kywls405/WineQueen/docs/WineQueen-development-report.pdf

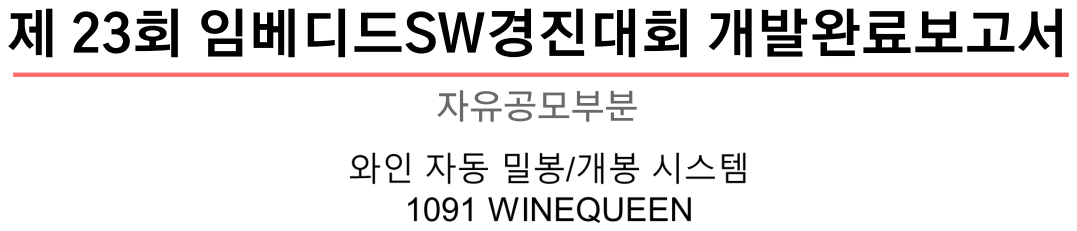
[picture p1: page 1]
제 23회 임베디드SW경진대회 개발완료보고서; 자유공모부분

## PART 1 - 개발개요

# 개발 배경 및 구현 동기

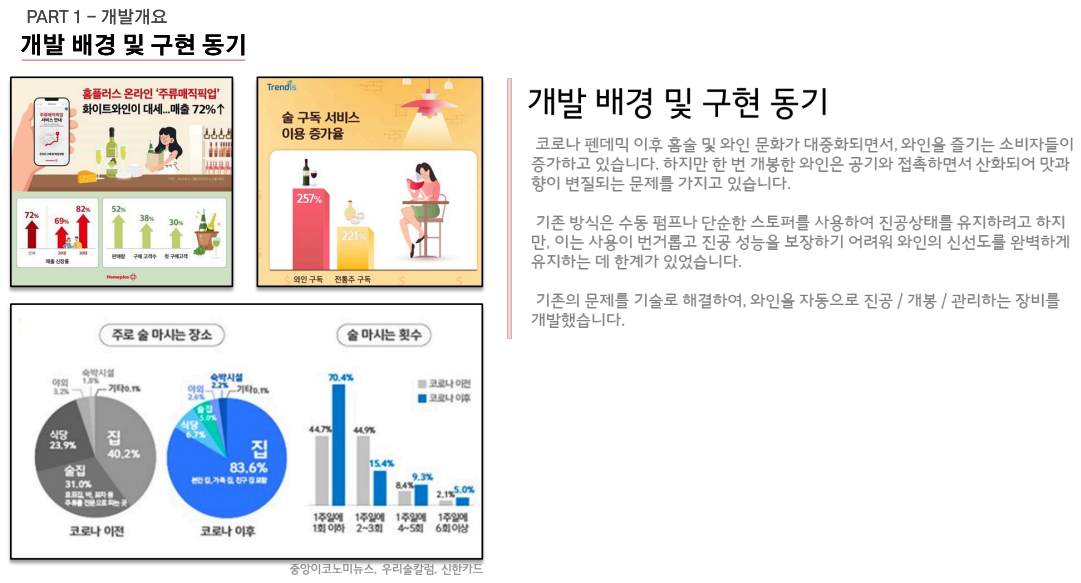
[picture p2: page 2]

## PART 1 - 개발개요

# 필요성 및 목표

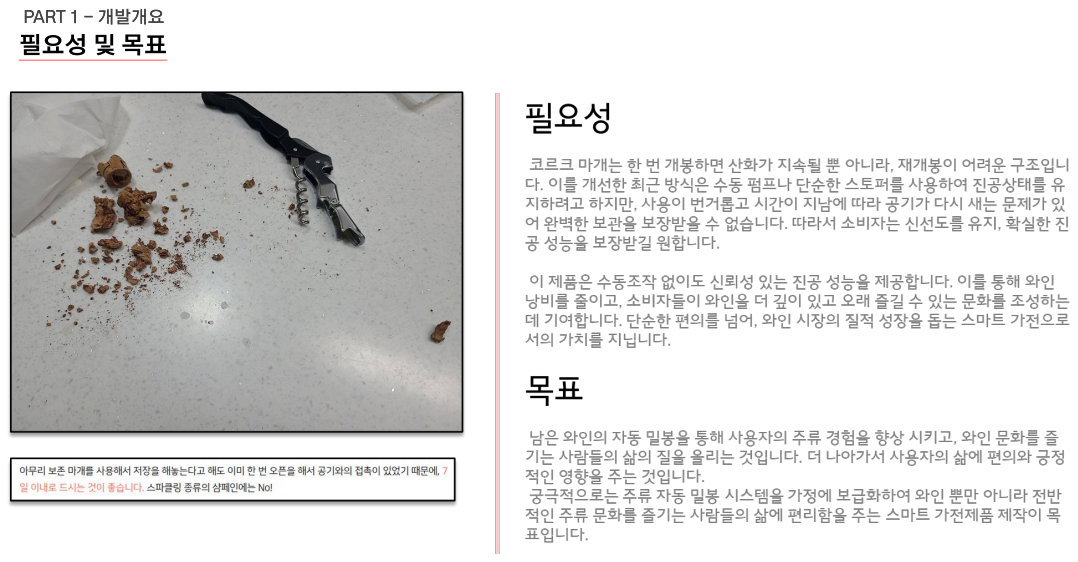
[picture p3: page 3]

## PART 1 - 개발개요

# 소스코드 및 시연동영상

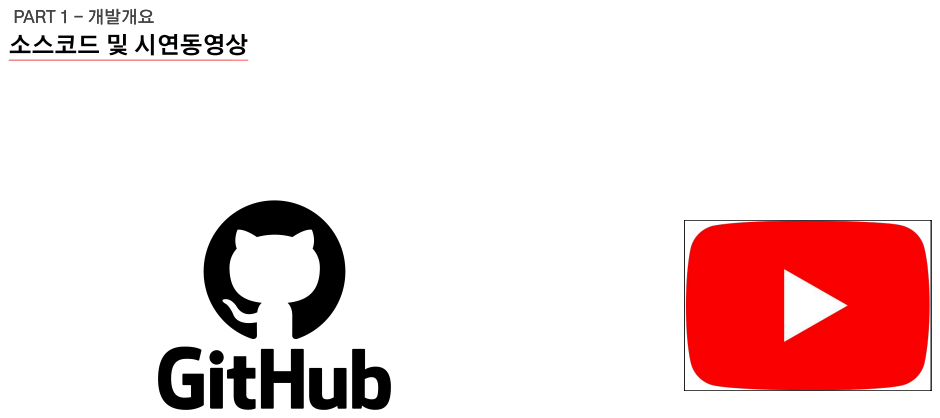
[picture p4: page 4]

## PART 2 - 개발 환경 설명

# HW구성 및 기능

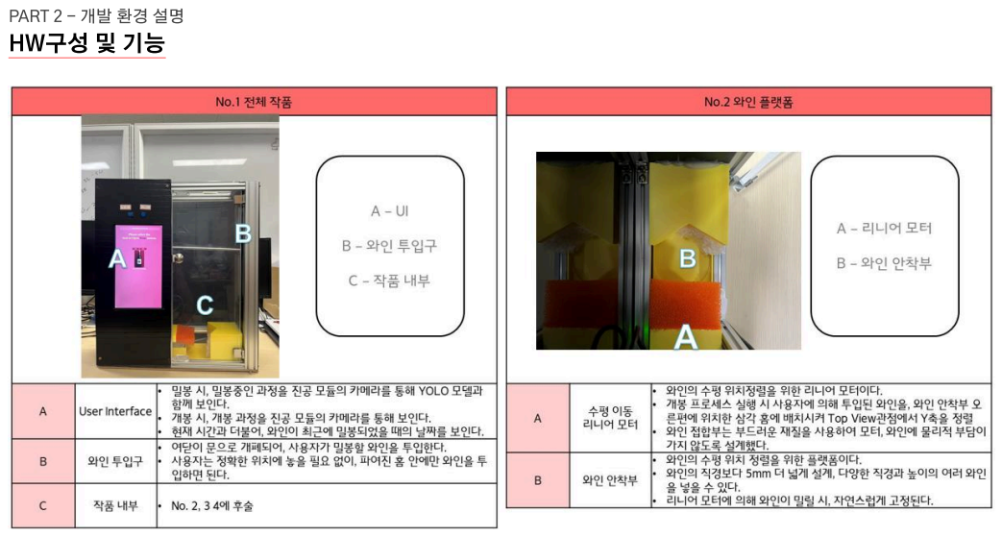
[picture p5: page 5]

## PART 2 - 개발 환경 설명

# HW구성 및 기능

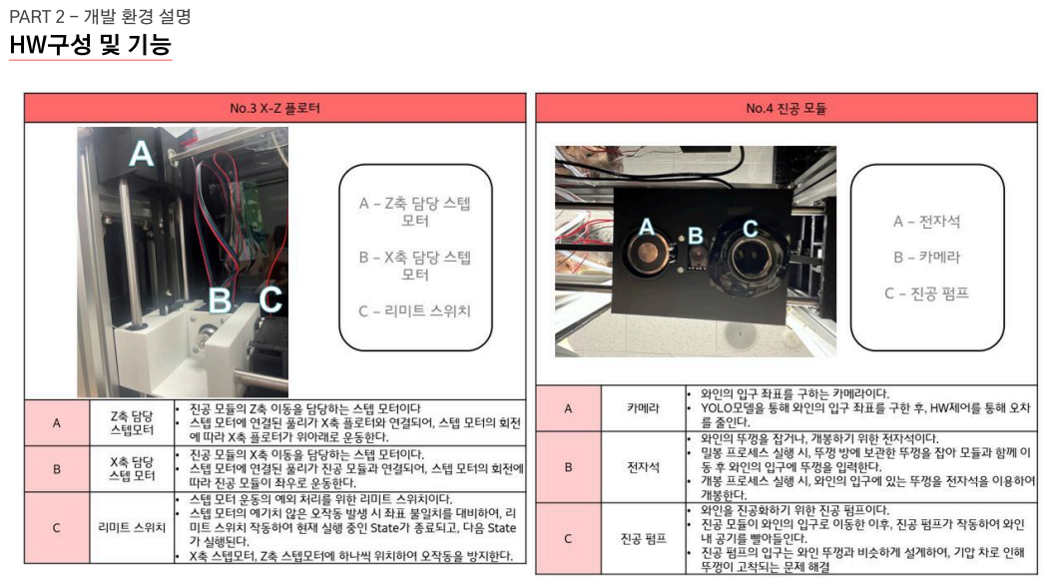
[picture p6: page 6]

### PART 2 - 개발 환경 설명

# 개발 환경 & 파트별 연결

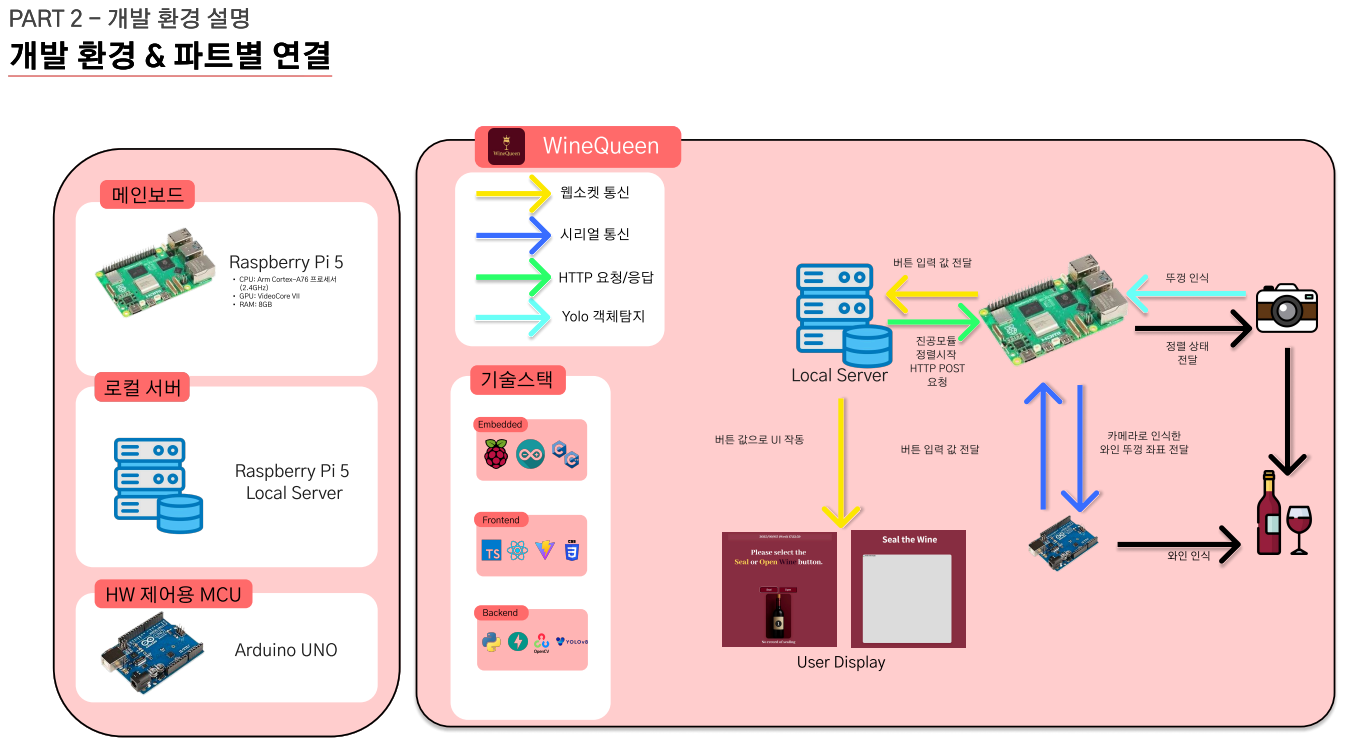
[picture p7: page 7]
Raspberry Pi 5 Local Server; Arduino UNO; 메인보드; 기술스택; Raspberry Pi 5; 기기하드웨어 제어; Local Server; 진공모듈 정렬시작; HTTP POST 요청; WineQueen; 시리얼 통신; 웹소켓 통신; Yolo 객체탐지; User Display; Frontend; Backend; Embedded

PART 2 - 개발 환경 설명
개발 환경 & 파트별 연결

HTTP 요청/응답

CPU: Arm Cortex-A76 프로세서
(2.4GHz)
GPU: VideoCore VII
RAM: 8GB

CPU: BCM2712 쿼드코어 Arm Cortex-A76 프로세서(2.4GHz)

카메라로 인식한

버튼 값으로 UI 작동
웹소켓으로 받은 버튼 값

HW 제어용 MCU

## PART 3 - 개발 프로그램 설명

# SW구성 및 핵심 기능

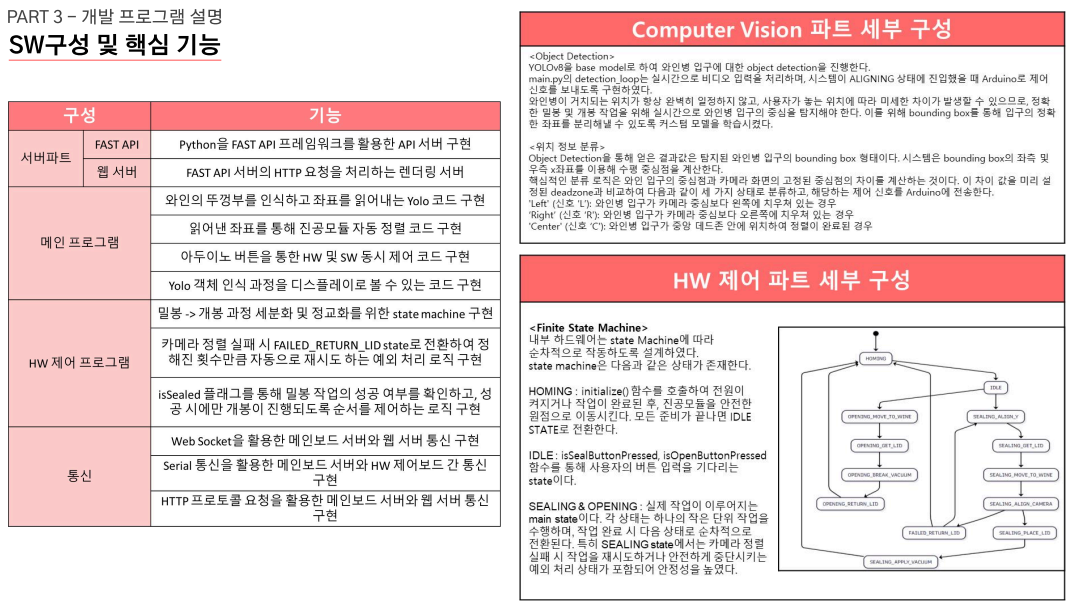
[picture p8: page 8]

## PART 3 - 개발 프로그램 설명

# 함수별 기능 - 1

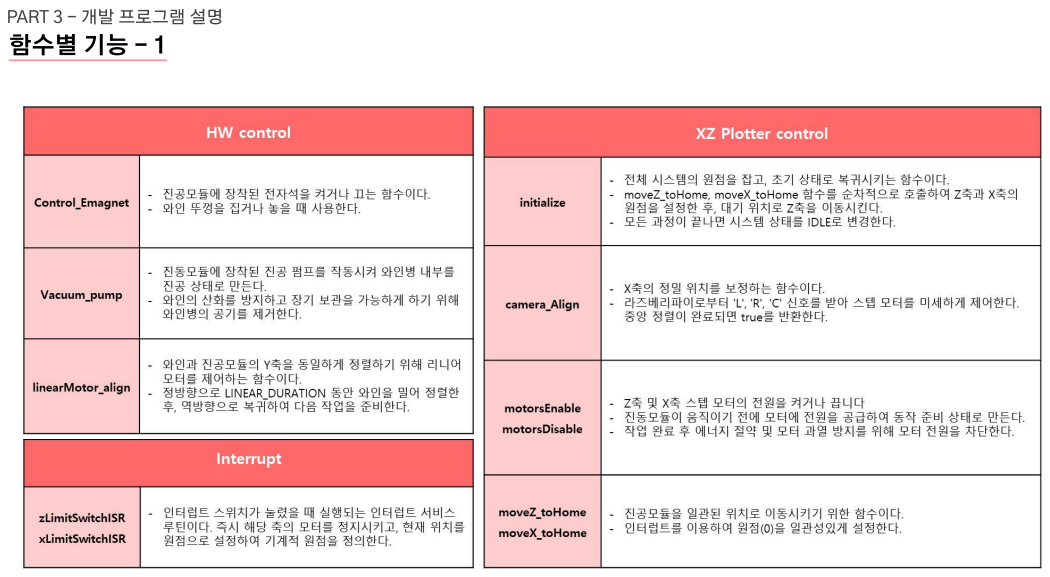
[picture p9: page 9]

## PART 3 - 개발 프로그램 설명

# 함수별 기능 - 2

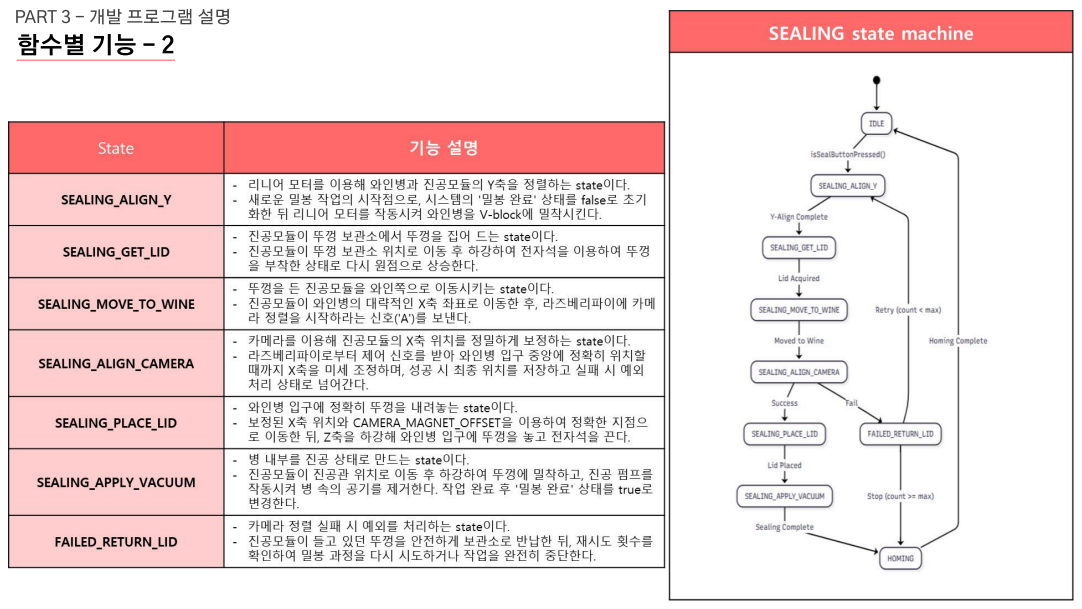
[picture p10: page 10]

## PART 3 - 개발 프로그램 설명

# 함수별 기능 - 3

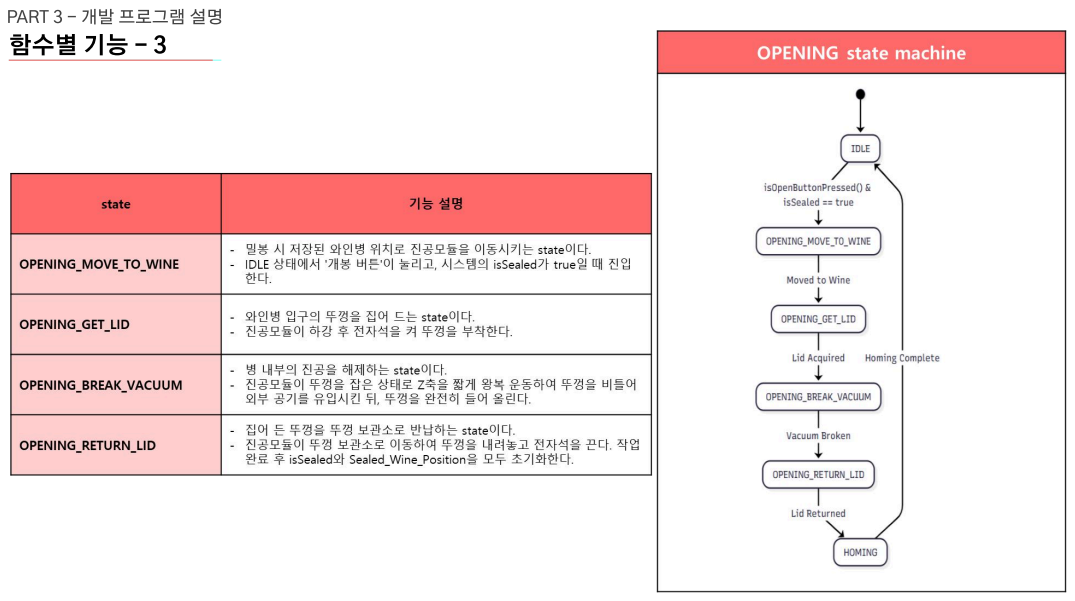
[picture p11: page 11]

## PART 3 - 개발 프로그램 설명

# 파일 구성 및 기술적 차별성

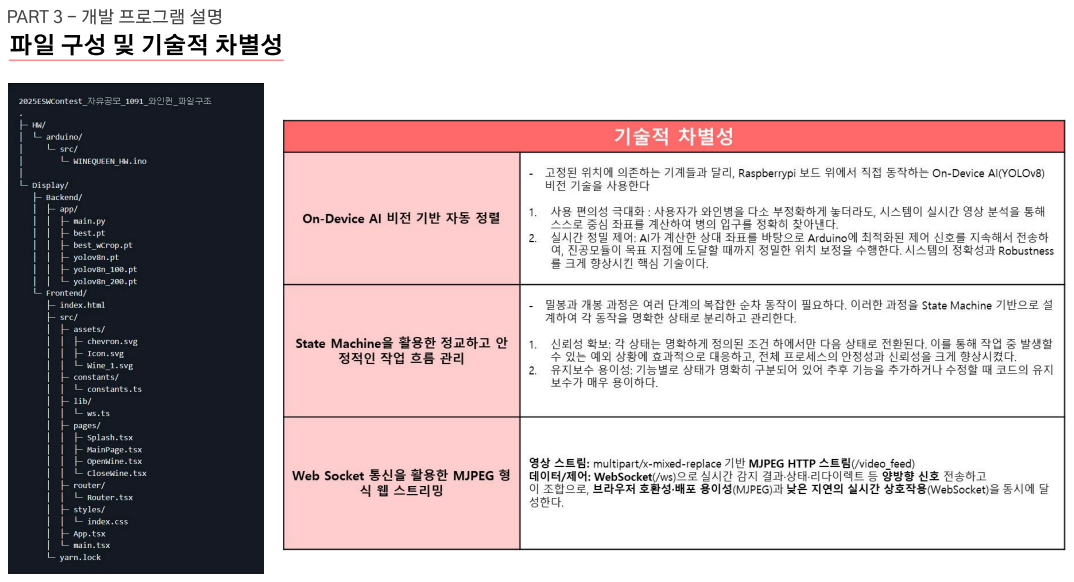
[picture p12: page 12]
파일 구성도 마크다운으로 구성하고 그냥 캡쳐 & 붙여넣 기 하는게 편 함

## PART 4 - 개발 중 발생한 장애요인과 해결방안

# 장애요인 및 해결방안

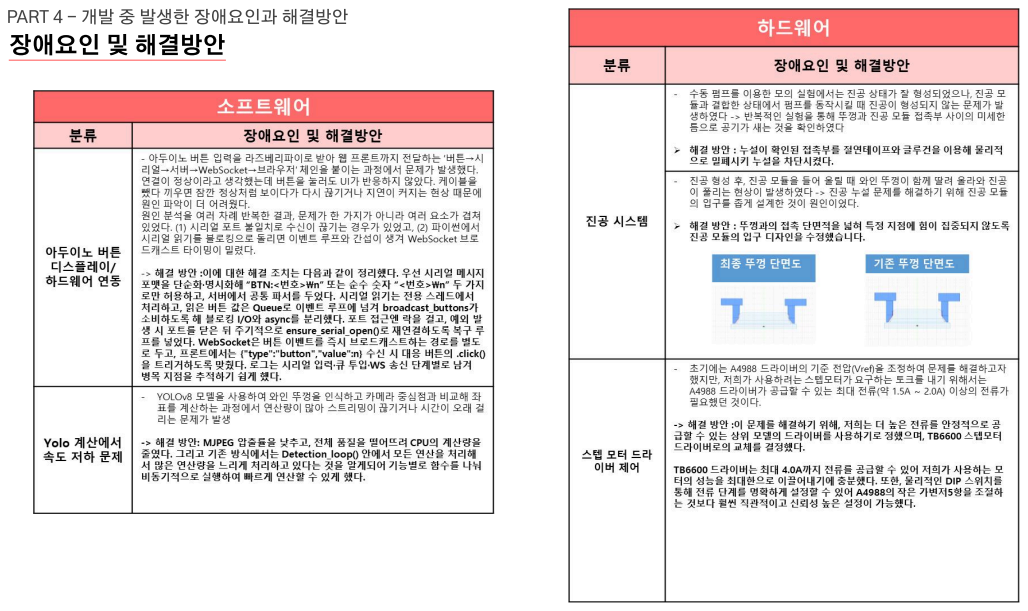
[picture p13: page 13]

## PART 5 - 개발 결과물의 차별성

# 작품의 차별성 및 우수성

기존 와인 스토퍼 | WineQueen

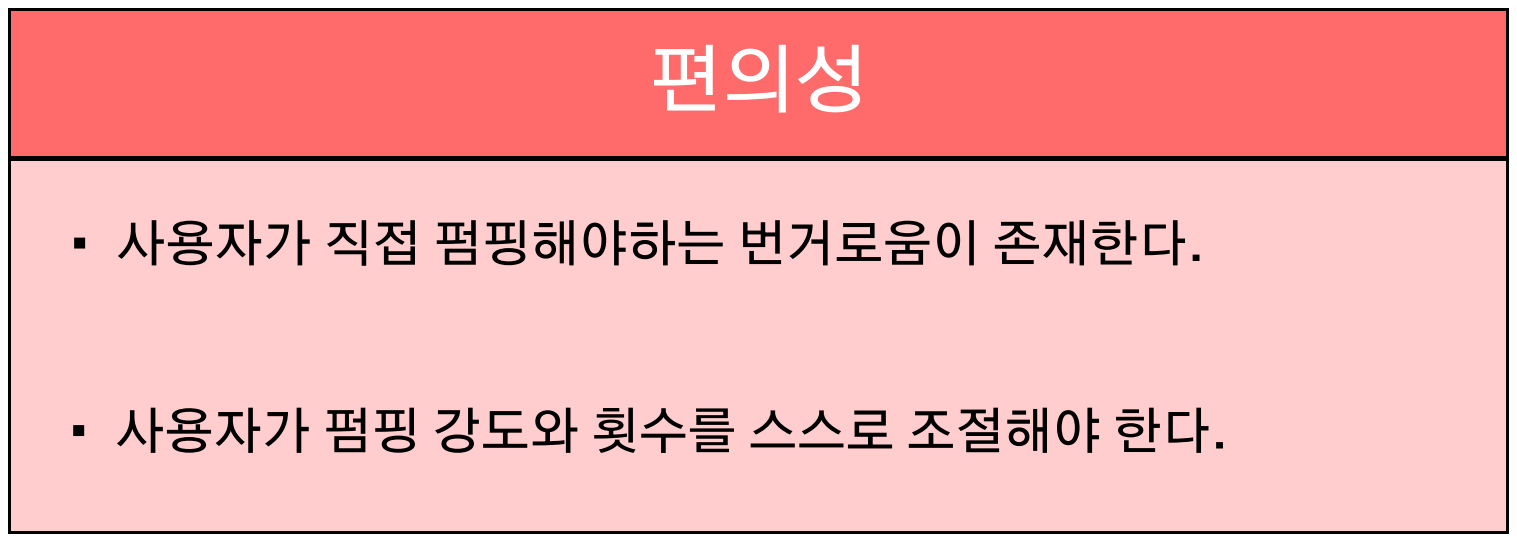
[picture p14: figure]
편의성; 사용자가 직접 펌핑해야하는 번거로움이 존재한다.; 사용자가 펌핑 강도와 횟수를 스스로 조절해야 한다.
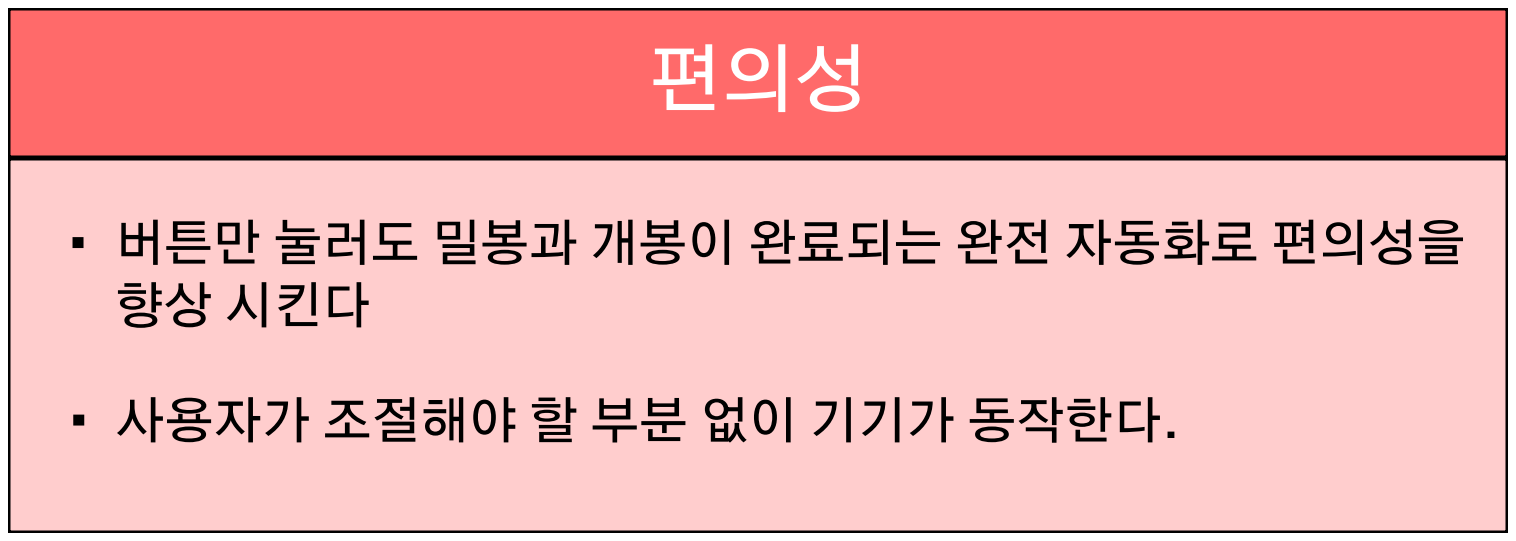
[picture p15: figure]
편의성; 버튼 만 눌러도 밀봉과 개봉이 완료되는 완전 자동화로 편의성을 향상 시킨다; 사용자가 조절해야 할 부분 없이 기기가 동작한다.
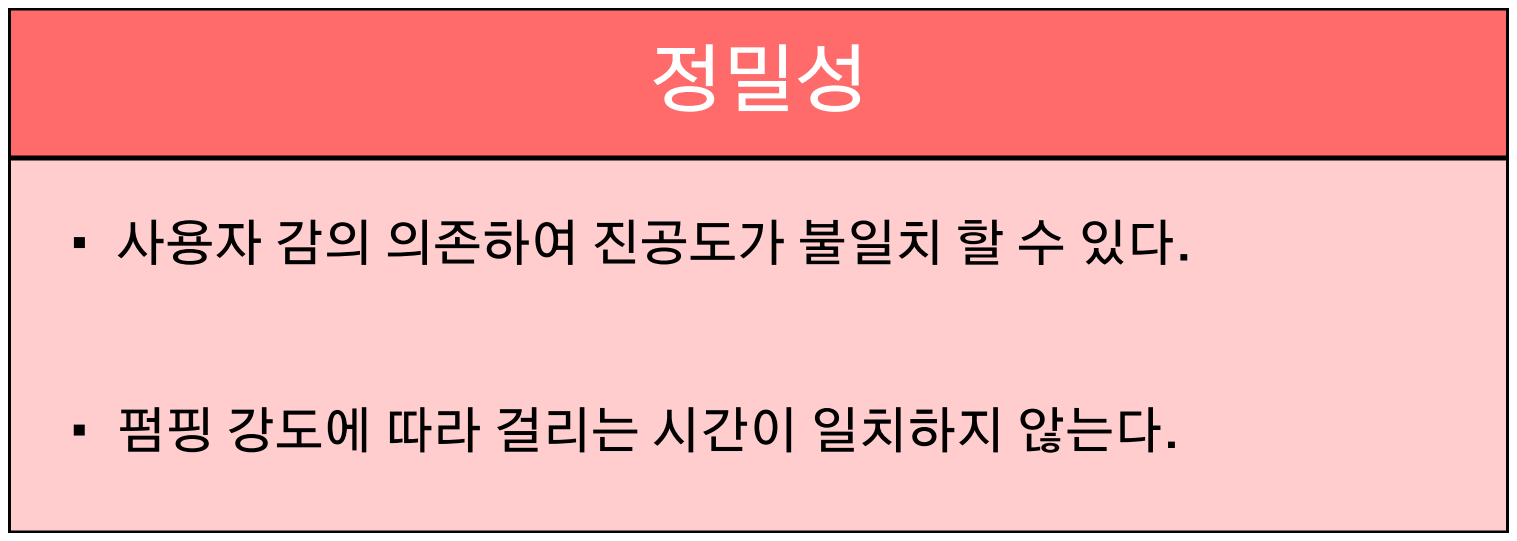
[picture p16: figure]
정밀성; 사용자 감의 의존하여 진공도가 불일치 할 수 있다.; 펌핑 강도에 따라 걸리는 시간이 일치하지 않는다.
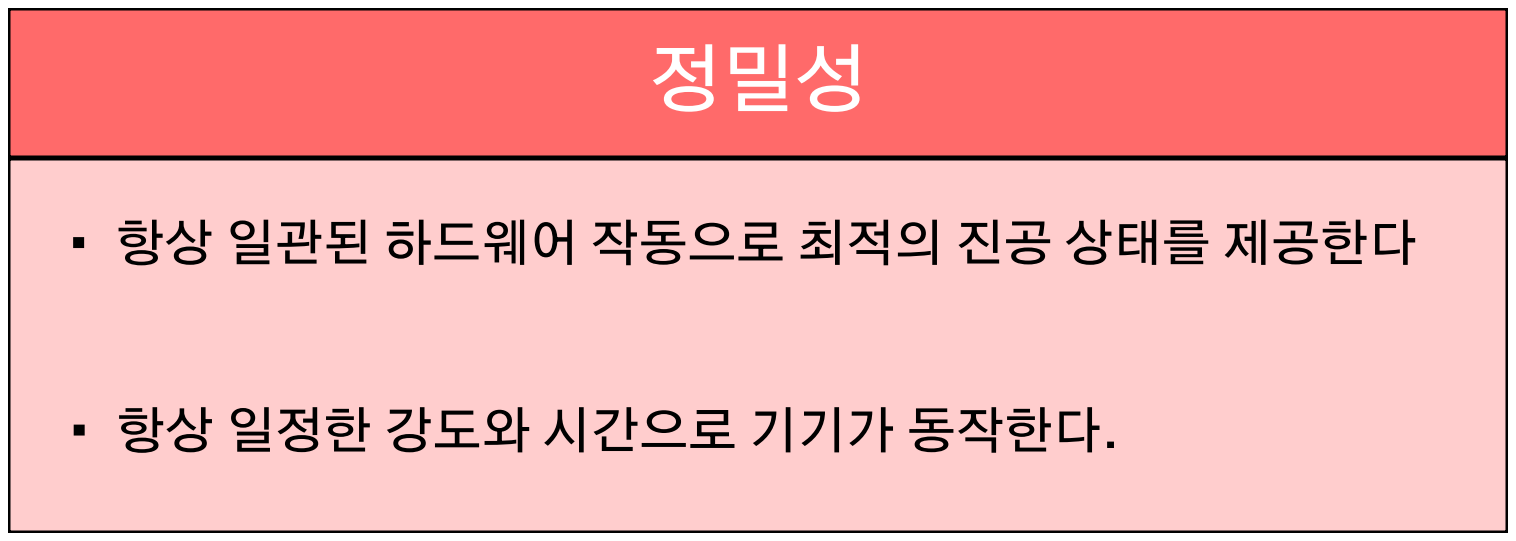
[picture p17: figure]
정밀성; 항상 일관된 하드웨어 작동으로 최적의 진공 상태를 제공한다; 항상 일정한 강도와 시간으로 기기가 동작한다.
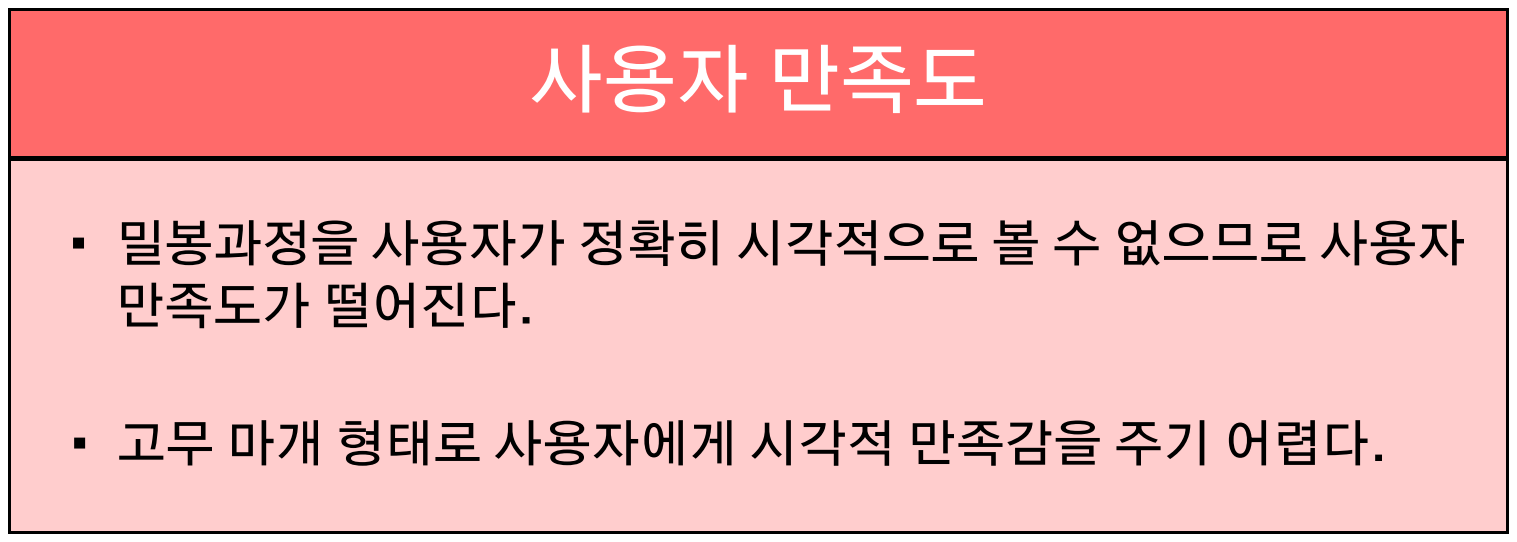
[picture p18: figure]
사용자 만족도; 밀봉과정을 사용자가 정확히 시각적으로 볼 수 없으므로 사용자 만족도가 떨어진다.; 고무 마개 형태로 사용자에게 시각적 만족감을 주기 어렵다.
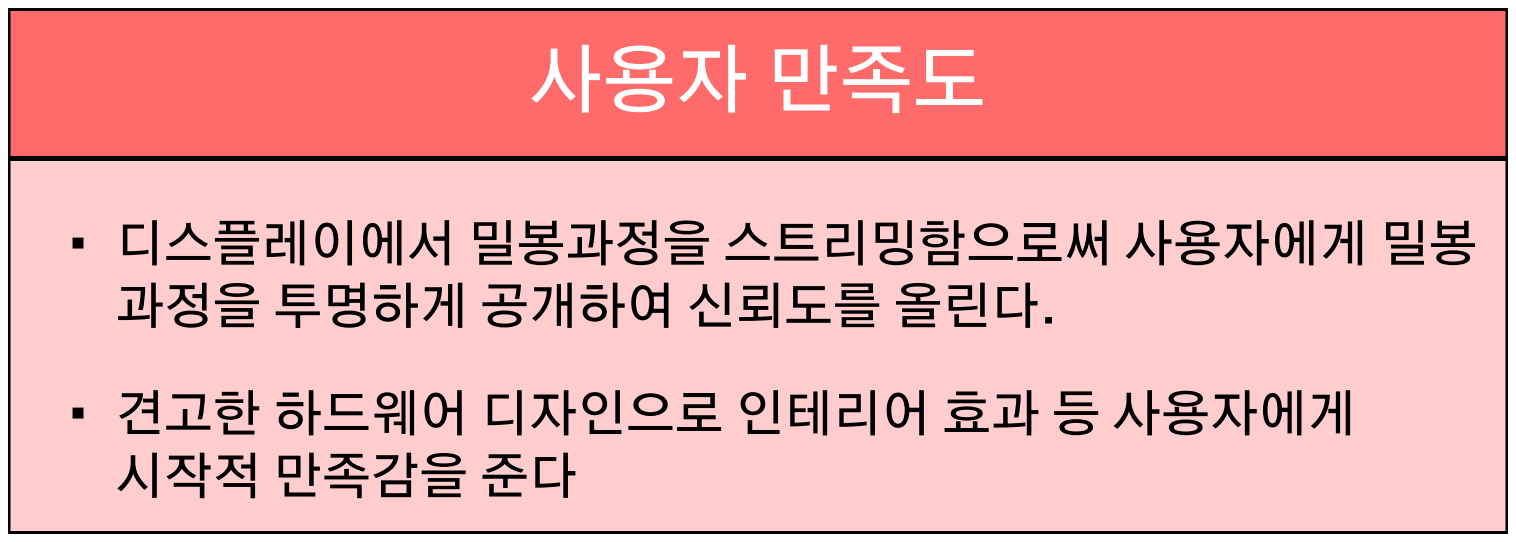
[picture p19: figure]
사용자 만족도; 디 스플레이에서 밀봉과정을 스트리밍함으로써 사용자에게 밀봉 과정을 투명하게 공개하여 신뢰도를 올린다.; 견 고한 하드웨어 디자인으로 인테리어 효과 등 사용자에게 시작적 만족감을 준다

## PART 6 - 개발 결과물의 파급력 및 기대효과

# 판매가치 및 시장성

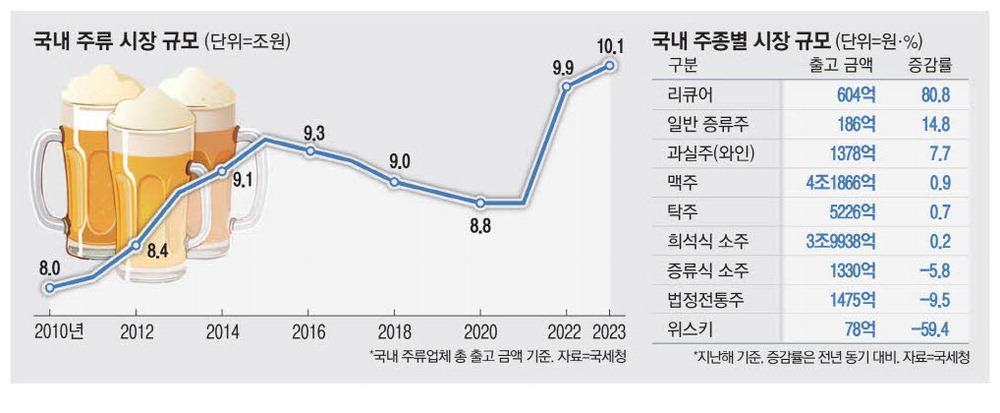
[picture p20: figure]

국세청의 조사 자료에 따르면,
국내 주류 시장의 규모는 점점 증가하고 있고, 와인 시장의 규모 역시 꾸준히 증가하고 있습니다. 이는 와인 소비가 더 이상 특정 계층만 즐기는 주종이 아닌 대중적 문화로 확산되고 있음을 방증합니다.

이러한 시장 상황에서 저희는 와인은 보통 한 번에 바로 먹는 것이 아닌 한병을
나눠 먹는다는 점에 집중하였고 그 와인 보관의 문제를 해결하는 것이 저희의 목표였습니다.

그러한 점에서 와인퀸은 홈술 문화를 즐기는 사람들과
와인을 잔 단위로 판매하는 업장의 수요에 응할 수 있는 제품이 될 것입니다.

와인퀸은 주류 문화를 즐기는 사람들의 삶의 질과 만족도를 올리는데 기여할 것입니다.
더 나아가 국내보다 훨씬 큰 규모의 와인 시장을 가진 다른 나라에도 이 제품을 수출할 계획입니다.

## PART 6 - 개발 결과물의 파급력 및 기대효과

# 활용성 및 발전가능성

활용성 | 발전가능성

## 가정용 활용

## 외식·서비스 업계 활용

와인 애호가: 한 번 개봉한 와인을 며칠~수주 동안 신선하게 보관할 수 있어 을 즐기는 듯한 경험 제공
소비자 편의성: 펌핑이나 특별한 기술 없이 버튼만 누르면 되므로 누구나 쉽 게 사용 가능
홈 파티·소규모 모임: 여러 병을 동시에 개봉해도 부담 없이 보관 가능

매번 새로운 와인

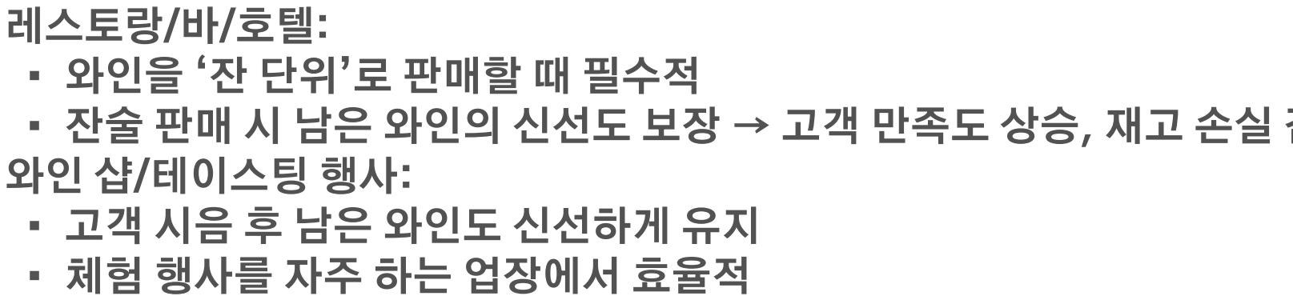
[picture p21: figure]
레스토랑/바/호텔: 와인을 ‘잔 단위’로 판매할 때 필수적; 와인 샵/테이스팅 행사: 고객 시음 후 남은 와인도 신선하게 유지 체험 행사를 자주 하는 업장에서 효율적

잔술 판매 시 남은 와인의 신선도 보장 → 고객 만족도 상승, 재고 손실 감소

## 비즈니스·시장적 가치

## 기술적 활용

프리미엄 와인 시장 확대: 고가 와인을 부담 없이 즐길 수 있도록 하여 소비 장벽 완화
스마트 주방 기기 트렌드 부합: IoT, 센서 기반 자동화 기기 수요 증가와 맞물 려 시장 경쟁력 확보
차별화 포인트: 기존 단순 스토퍼와 달리 정밀 센서 제어 + 완전 자동화"라 는 기술적 차별성

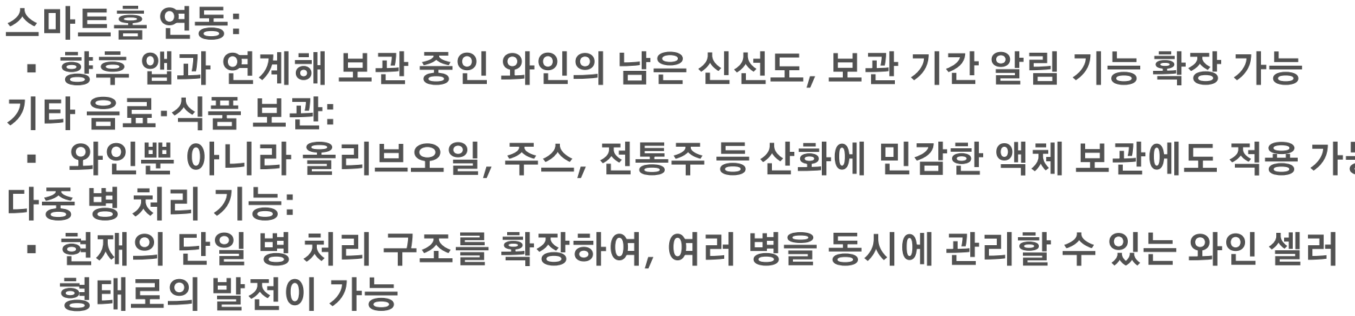
[picture p22: figure]
스마트홈 연동:; 형태로의 발전이 가능

향후 앱과 연계해 보관 중인 와인의 남은 신선도, 보관 기간 알림 기능 확장 가능

와인뿐 아니라 올리브오일, 주스, 전통주 등 산화에 민감한 액체 보관에도 적용 가능

현재의 단일 병 처리 구조를 확장하여, 여러 병을 동시에 관리할 수 있는 와인 셀러

## PART 7 - 개발 일정 및 업무 분장

# 개발 일정

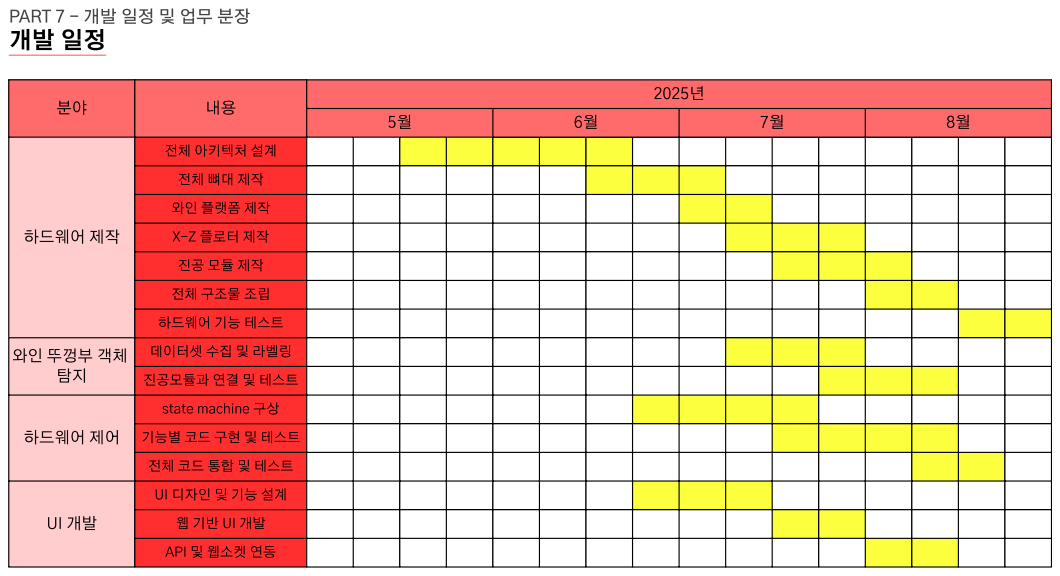
[picture p23: page 17]
하드웨어 제작; 하드웨어 제어

전체 아키텍처 설계

와인 플랫폼 제작

X-Z 플로터 제작

전체 구조물 조립

하드웨어 기능 테스트

와인 뚜껑부 객체 탐지 | 데이터셋 수집 및 라벨링

진공모듈과 연결 및 테스트

state machine 구상

기능별 코드 구현 및 테스트

전체 코드 통합 및 테스트

UI 디자인 및 기능 설계

API 및 웹소켓 연동

## PART 7 - 개발 일정 및 업무 분장

# 업무 분장

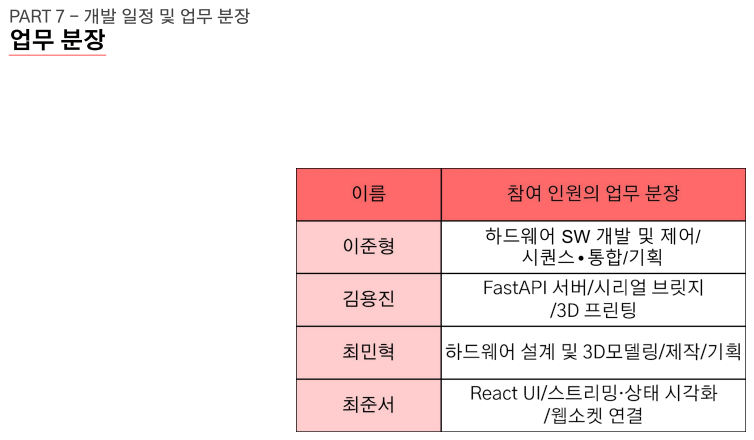
[picture p24: page 18]
