kywls405/WineQueen/(commit log)

2025-07-17 Feat: Test 페이지 구현
2025-07-17 Design: 화면 꽉 차게 + 글씨 중앙 정렬
2025-07-17 Delete: import React 삭제
2025-07-17 Readme 변경
2025-07-17 Modify: 와인선택화면 수정
2025-07-17 Feat: 페이지 뼈대 구현
2025-07-17 Feat: 메인페이지에 시간 추가
2025-07-17 Feat: 타이머 자동 이동 반영
2025-07-20 Design: 디자인 다듬기
2025-07-20 Design: 패딩 추가 및 폰트 수정
2025-07-20 Design: 스플래시 디자인 추가
2025-07-20 Feat: open 했을 때도 시간 초기화
2025-07-20 Merged Raspberry Pi local changes into existing GitHub repo
2025-07-20 Streaming On Web. Yolo 씌웠으나 어두워서 확인 불가. 실행되지 않을 것으로 예상해 코드 개선 필요함.
    현재 영상을 띄우고 Yolo 값이 나오는 css를 추가로 씌우는 구조.
2025-07-30 Feat: 날짜 추가 및 리드미 수정
2025-07-31 ip 수정
2025-07-31 좌표 생성
2025-07-31 Serial - Yolo 구현 테스트 1
2025-08-06 Feat: 스플래시 화면 구현 중
2025-08-06 Feat: 네트워크 아이피 전역변수 추가
2025-08-06 Feat: 메인페이지 퍼블리싱 중
2025-08-06 Feat: 전체 페이지 구현 완료
2025-08-06 Feat: 개봉/밀봉 버튼 추가
2025-08-06 Fix: 스플래시 화면 중앙 정ㄹ렬
2025-08-06 Desing: 헤더 올리기
2025-08-07 Feat: 방향키와 엔터로 버튼 선택기능 추가
2025-08-13 Feat: 와인 1개로 변경
